fue19389/Placa-Nervio-Vago-Fase-5/Presentacion/pcb6.jpg

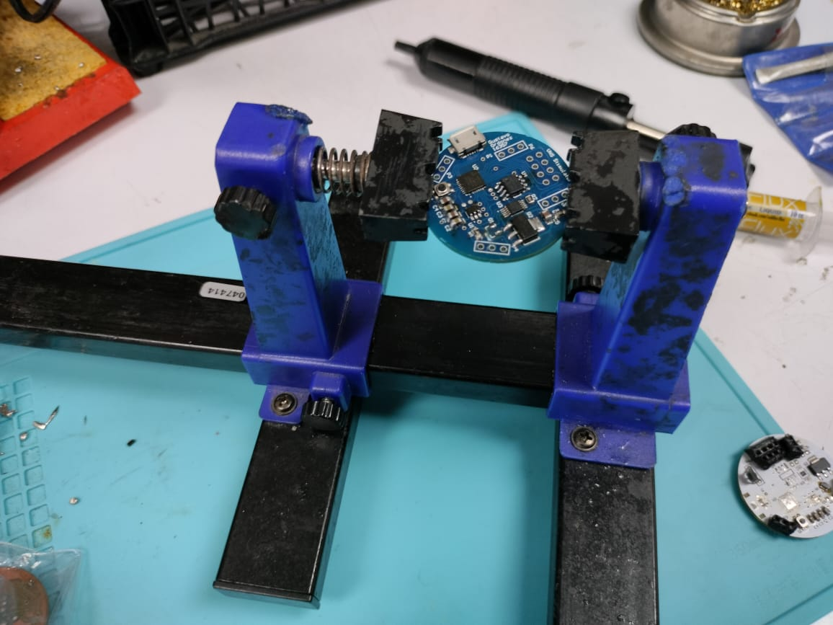
Presentacion/pcb6.jpg
