fue19389/Placa-Nervio-Vago-Fase-5/Presentacion/pcb4.jpg

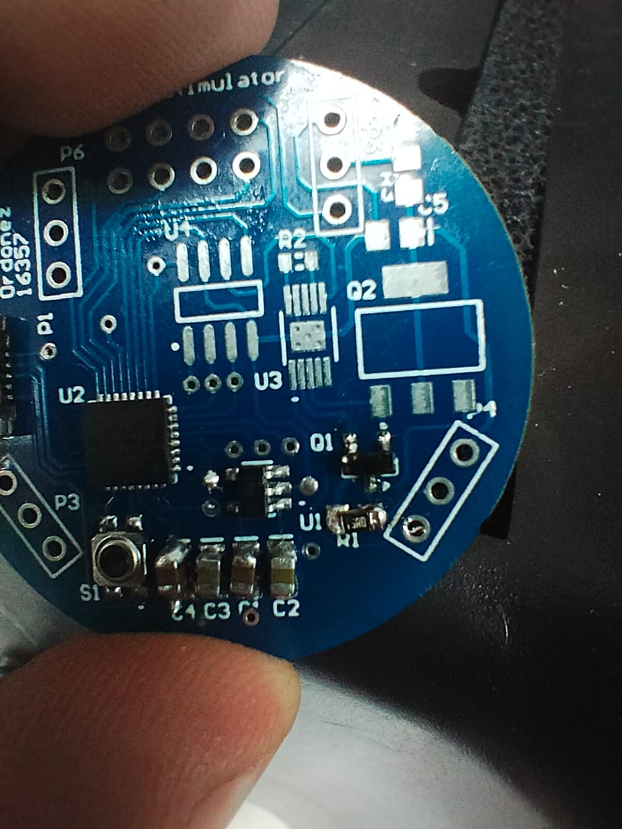
Presentacion/pcb4.jpg
