fue19389/Placa-Nervio-Vago-Fase-5/README.md

# Placa-Nervio-Vago-Fase-5

Este repositorio tiene como objetivo mostrar la documentación utilizada para la realización parcial del proyecto Estimulador del Nervio Vago, el cual no pudo ser terminado. 
Sin embargo, contiene las observaciones para que la próxima persona encargada sea capaz de continuar con la investigación y desarrollo de prototipos.
