fue19389/Placa-Nervio-Vago-Fase-5/Simulaciones/README.md

# Simulaciones

En este apartado encontrarán: 

- SAMD-D21.pdf: Este archivo es la hoja de datos del microcontrolador utilizado para la generación de pulsos del Estimulador del Nervio Vago.

- XTR111.zip: Este archivo contiene los modelos Spice del integrado que funciona para convertir voltaje a corriente.

- Spicemodels_p_channel: Este archivo contiene los modelos spice para un MOSFET Canal P de 100v-

- Simulaciones: En esta carpeta se encuentran los archivos utilizados para la simulación en LTSpice VII del convertidor de voltaje a corriente.
