fue19389/Placa-Nervio-Vago-Fase-5/Reporte/README.md

# Reporte final del estimulador del nervio vago

En este reporte se podrá encontrar una descripción de las observacinoes realizadas para el proyecto del Estimulador del Nervio Vago. En este caso se presentan resúmenes de: 
- Revisión de software
- Revisión de componentes y adjunto de hojas de datos
- Resumen de simulaaciones de funcionamiento
- Revisión parcial de funcionamiento (de la sección del convertidor de voltaje a corriente)
- Conclusiones
- Recomendaciones
