fue19389/Placa-Nervio-Vago-Fase-5/Tesis/README.md

# Documento de tesis

Este documento en formato PDF muestra la tesis incompleta que fue inciada por Gerardo Fuentes.
