fue19389/Placa-Nervio-Vago-Fase-5/Presentacion/README.md

# Documentos utilizados para la presentación de resultados

En este apartado encontrarán: 
- Archivos con extensión .jpg los cuales fueron usados para hacer demostraciones de los avances de resultados.
- Un archivo nombrado "22" el cual contiene la última presentación de avances ralizada.
