fue19389/Placa-Nervio-Vago-Fase-5/Simulaciones/LTSpice/README.md

XTR111 LTspice Model
====================

XTR111 LTspice basado en el modelo encontrado en https://e2e.ti.com/support/amplifiers/precision_amplifiers/f/14/t/170869 for TINA-TI.

Archivos
-----

- XTR111.asc: Esquemático con el modelo XTR111 LTspice.
- XTR111.asy: Symbolo para el uso de XTR111 en otros esquemáticos.
- XTR111 Simulation.asc: Ejemplo de utilización del modelo.

Uso del modelo
----------------

Para el uso del XTRR111 se deben copiar los archivos XTR111.asc y XTR111.asy en el directorio de trabajo.

Instrucciones:
- Click on "Component".
- En la pestaña o botón "Top Directory", seleccionar el directorio actual.
- En este espacio debería aparecer el integrado XTR111, seleccionar y colocar en el esquemático.

Notas
-----

- Este modelo únicamene funciona con LTSpice
- Este modelo no es el oficial, y fue creado para para ayudar a los clientes y otras personas intersadas en entender el funcionamiento del XTR111. No será preciso al simular varios de los parámetros de la hoja de datos, pero es útil para entender el funcionamiento.

Licencia
-------

El modelo XTR111 LTspice es distribuido bajo los términos del la licencia del MIT.
