fue19389/Placa-Nervio-Vago-Fase-5/Presentacion/falstad.jpg

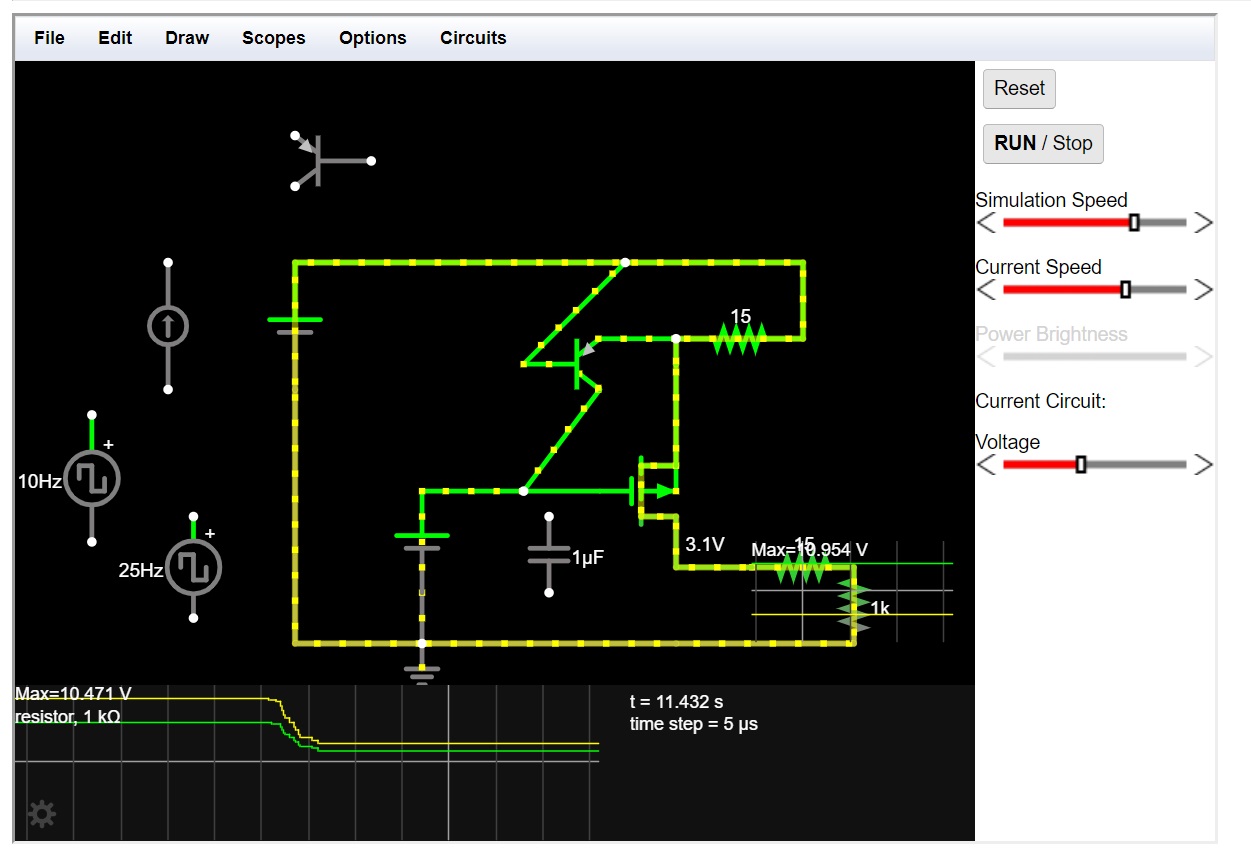
Presentacion/falstad.jpg
