fue19389/Placa-Nervio-Vago-Fase-5/Presentacion/pcb2.jpg

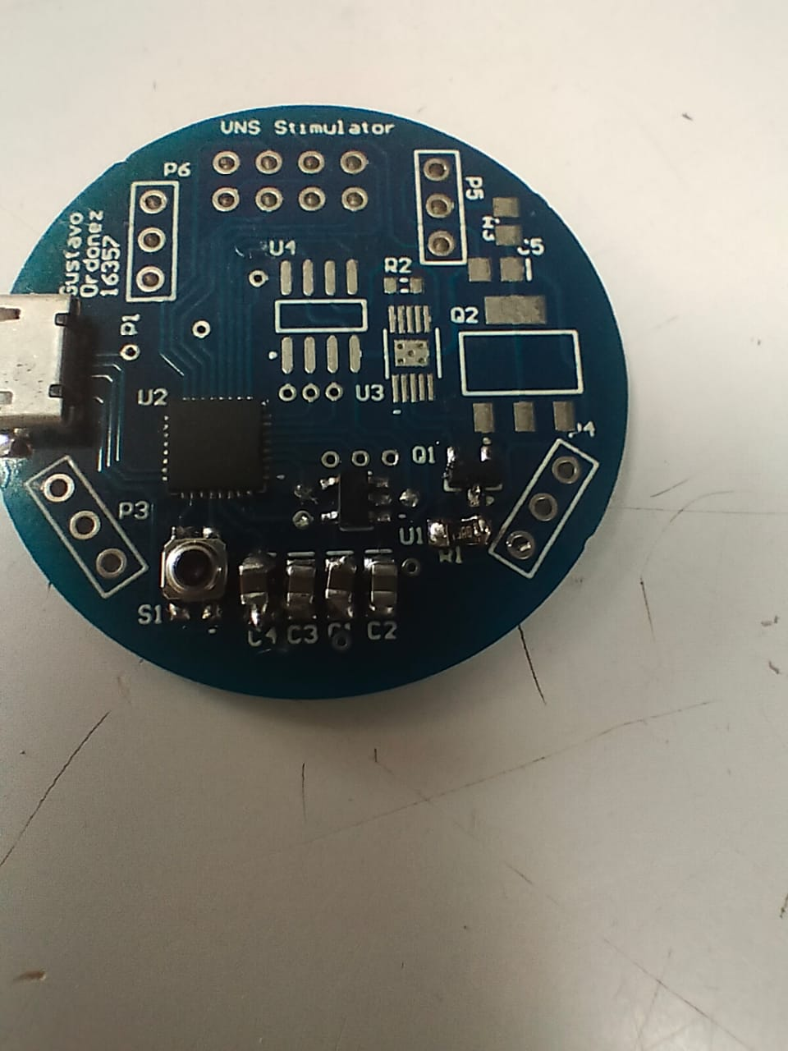
Presentacion/pcb2.jpg
