fue19389/Placa-Nervio-Vago-Fase-5/Presentacion/pcb3.jpg

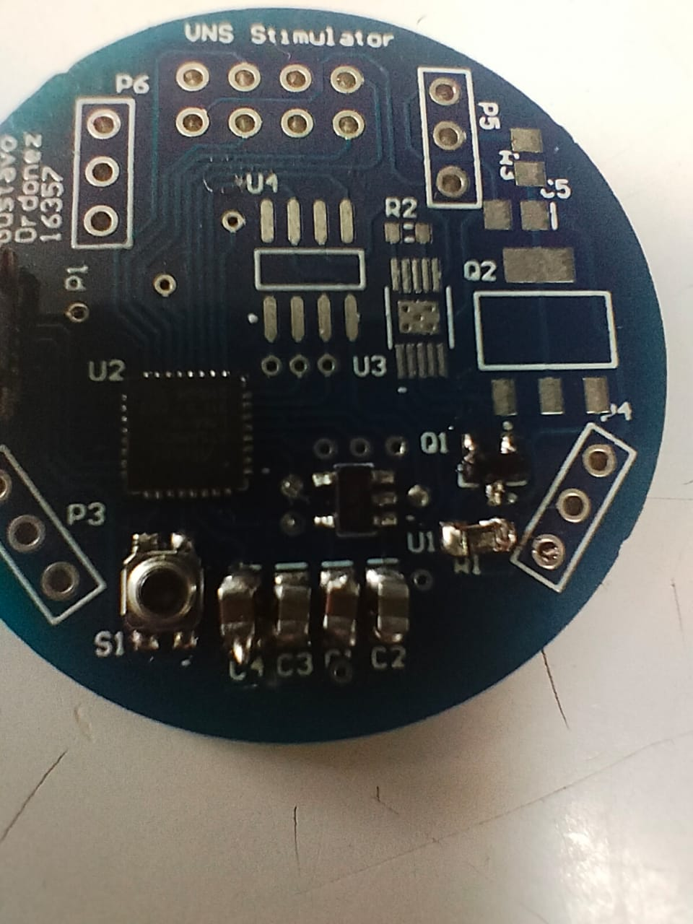
Presentacion/pcb3.jpg
