fue19389/Placa-Nervio-Vago-Fase-5/Presentacion/pcb5.jpg

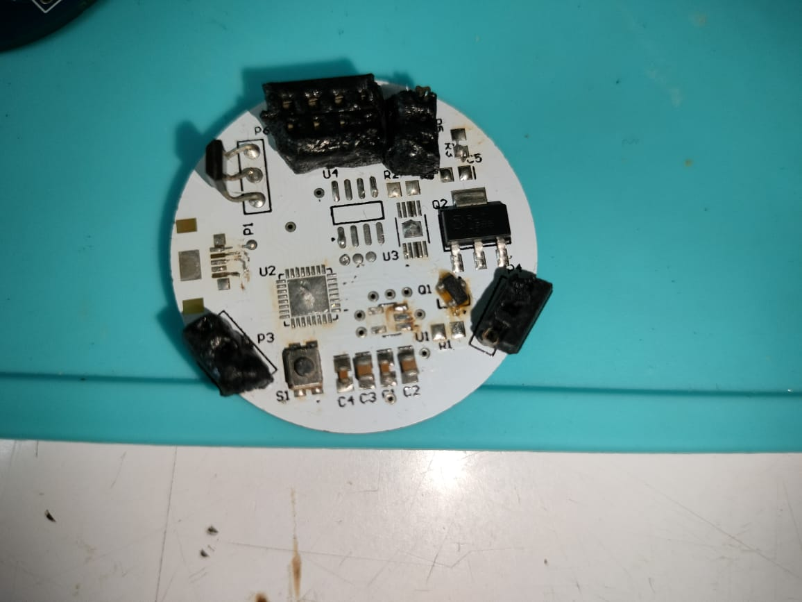
Presentacion/pcb5.jpg
