fue19389/Placa-Nervio-Vago-Fase-5/Presentacion/proto1.jpg

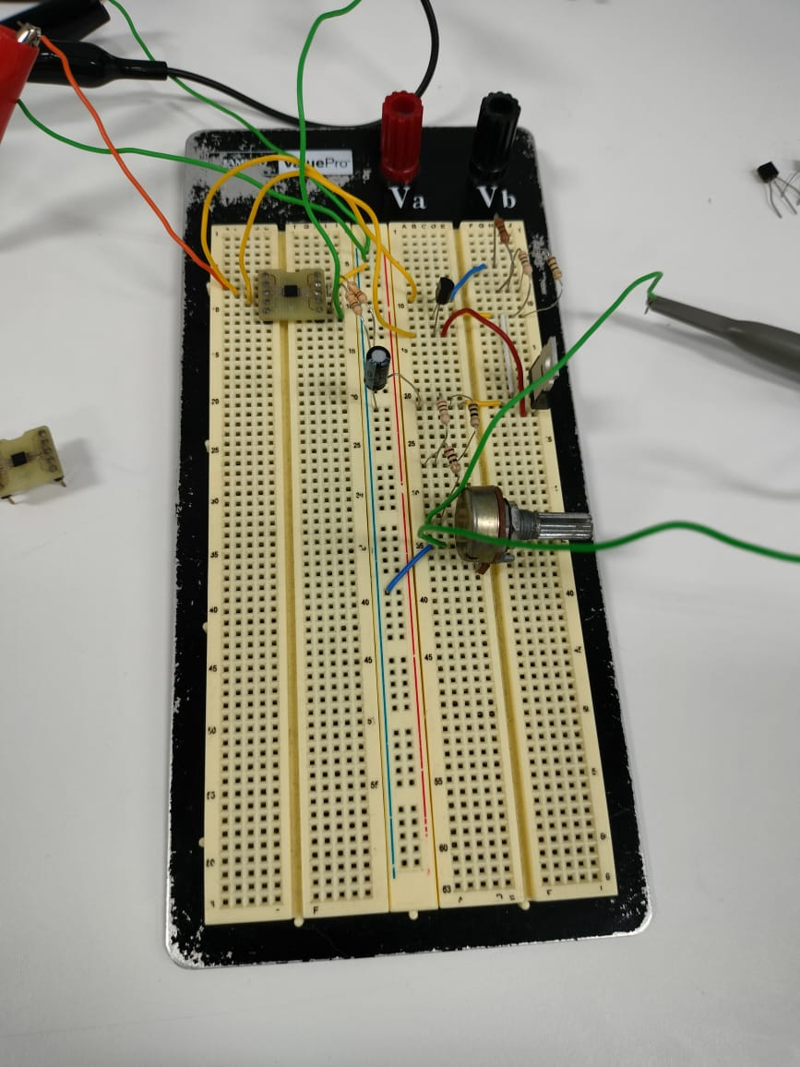
Presentacion/proto1.jpg
