fue19389/Placa-Nervio-Vago-Fase-5/Presentacion/proto2.jpg

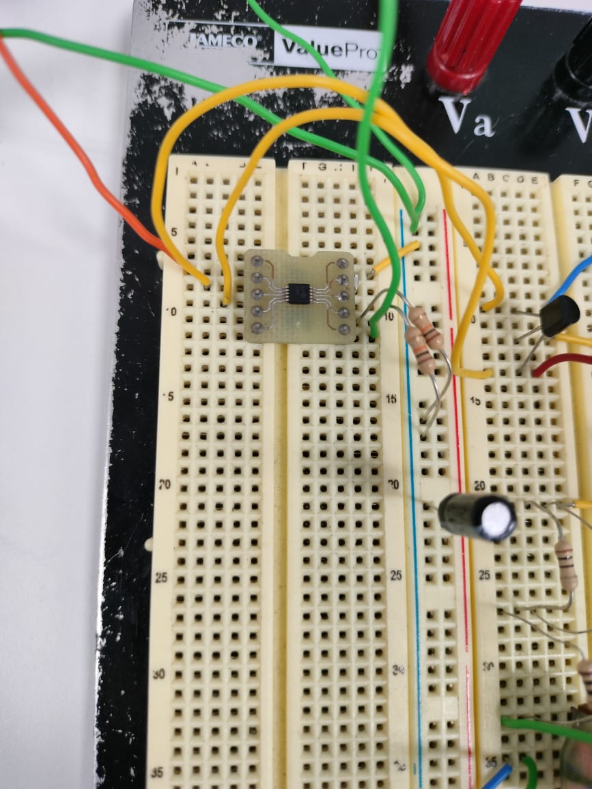
Presentacion/proto2.jpg
