fue19389/Placa-Nervio-Vago-Fase-5/Presentacion/vi.jpg

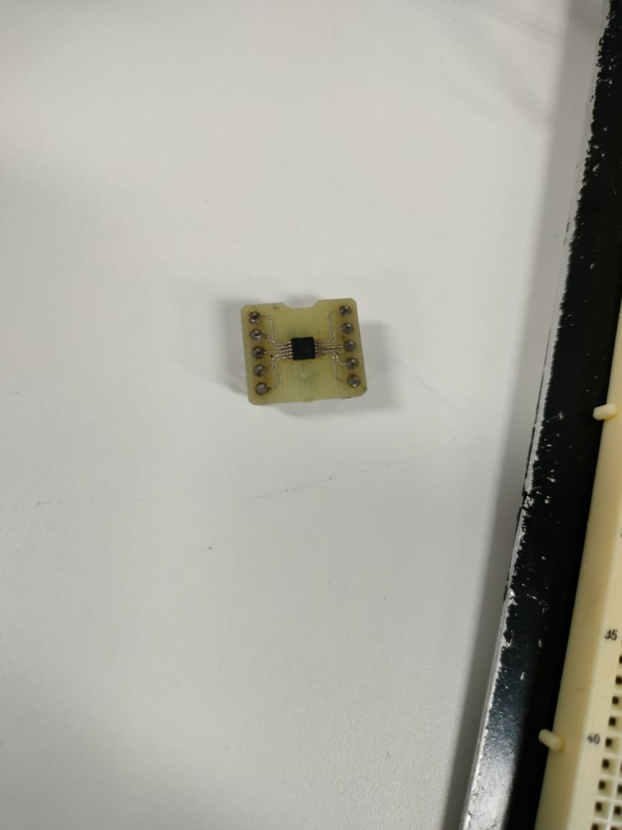
Presentacion/vi.jpg
