fue19389/Placa-Nervio-Vago-Fase-5/Presentacion/VI_5K_SET.jpg

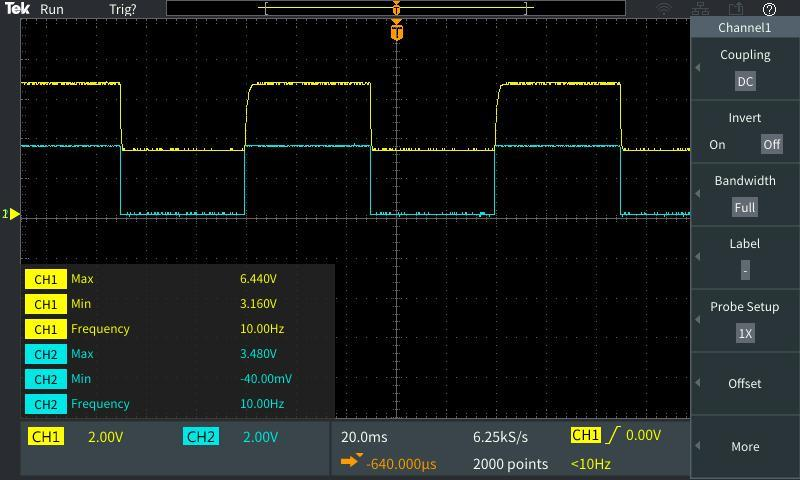
Presentacion/VI_5K_SET.jpg
