fue19389/Placa-Nervio-Vago-Fase-5/Presentacion/WhatsApp Image 2023-09-01 at 03.13.22.jpg

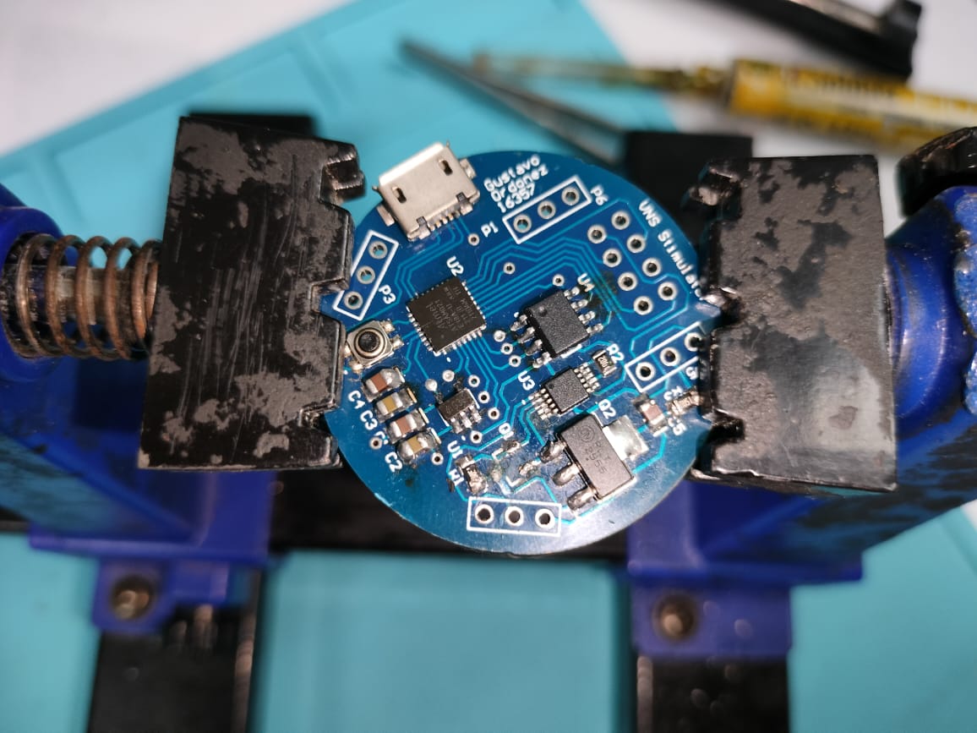
Presentacion/WhatsApp Image 2023-09-01 at 03.13.22.jpg
