fue19389/Placa-Nervio-Vago-Fase-5/Presentacion/22.pdf

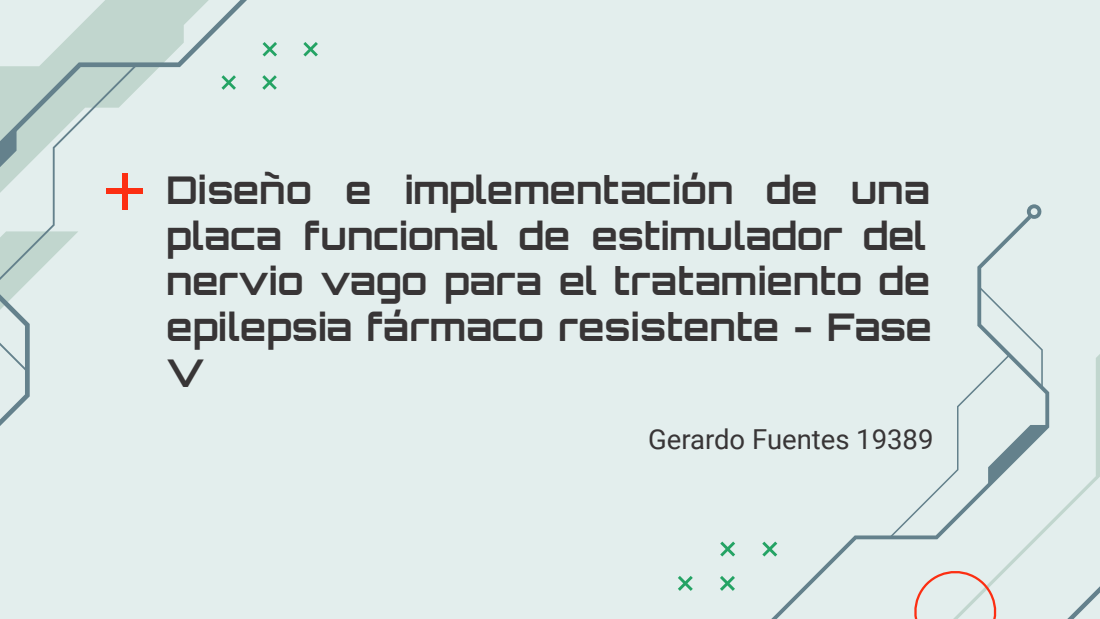
[picture p27: page 1]
Gerardo Fuentes 19389

Diseño e implementación de una
placa funcional de estimulador del
nervio vago para el tratamiento de
epilepsia fármaco resistente - Fase

## ÍNDICE

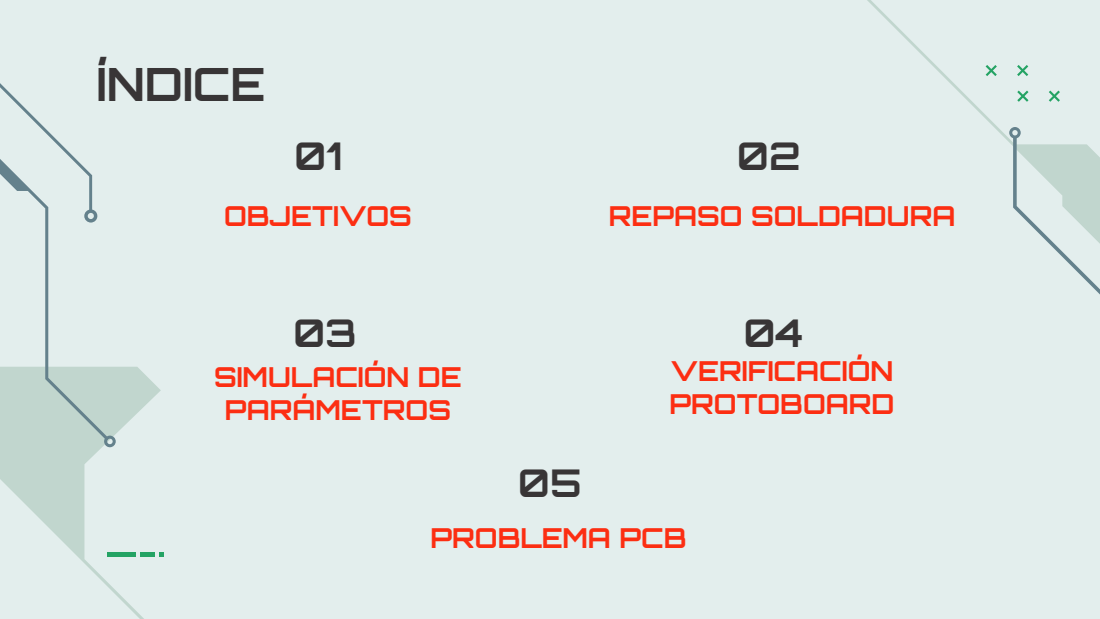
[picture p28: page 2]
OBJETIVOS; 03 SIMULACIÓN DE PARÁMETROS; 04 VERIFICACIÓN PROTOBOARD; REPASO SOLDADURA; PROBLEMA PCB

01

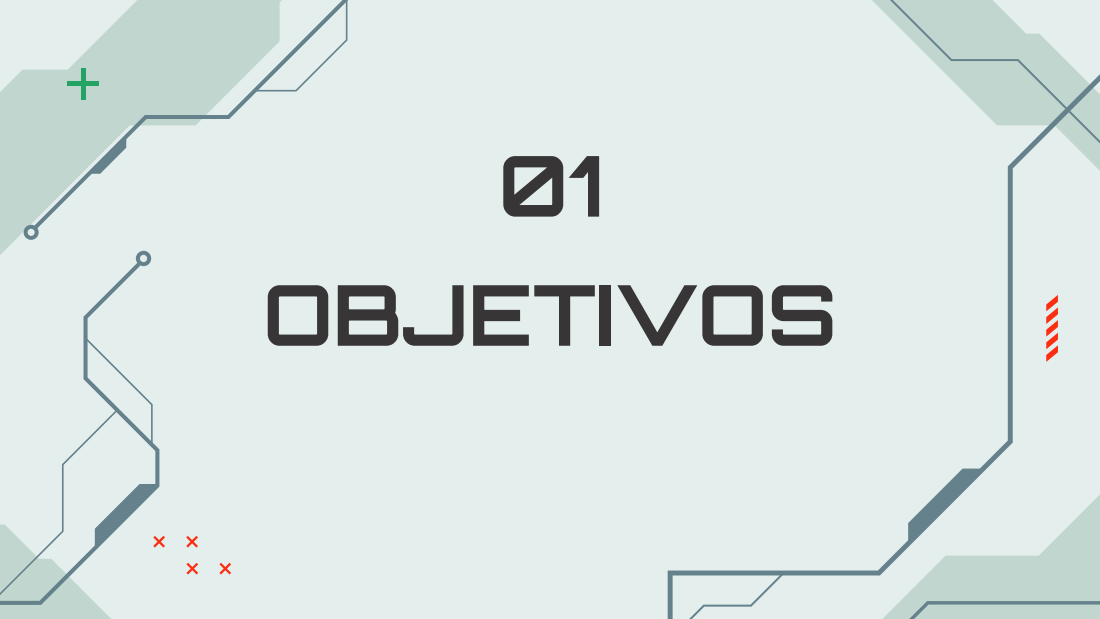
[picture p29: page 3]
OBJETIVOS

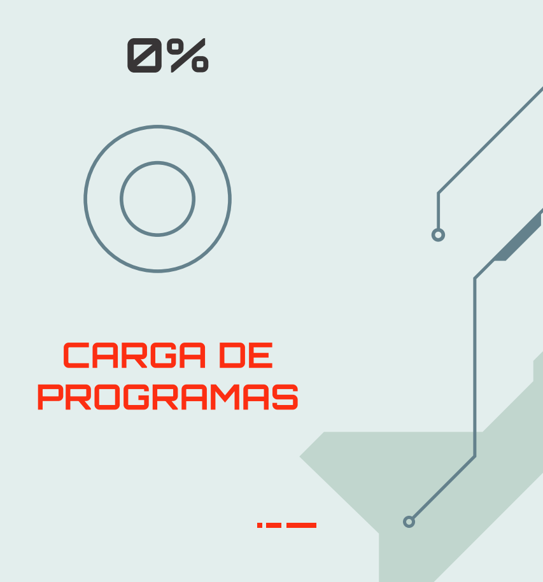
[picture p30: figure]
CARGA DE PROGRAMAS

60% | 0%

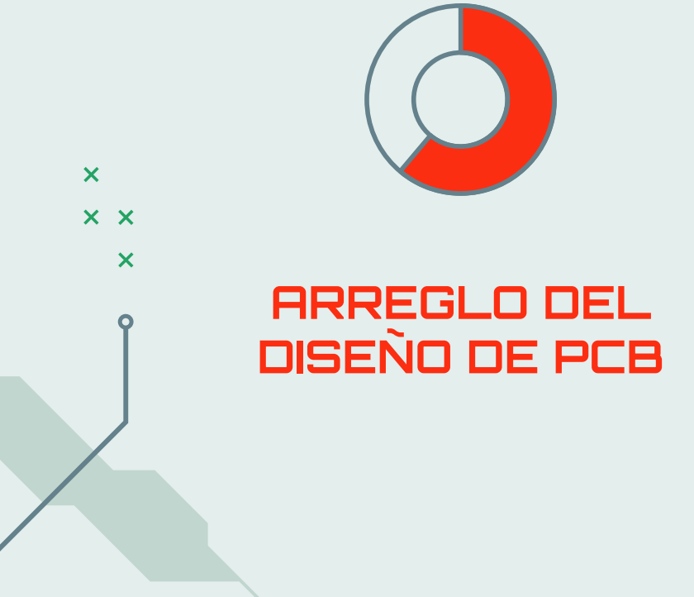
[picture p31: figure]
ARREGLO DEL DISEÑO DE PCB

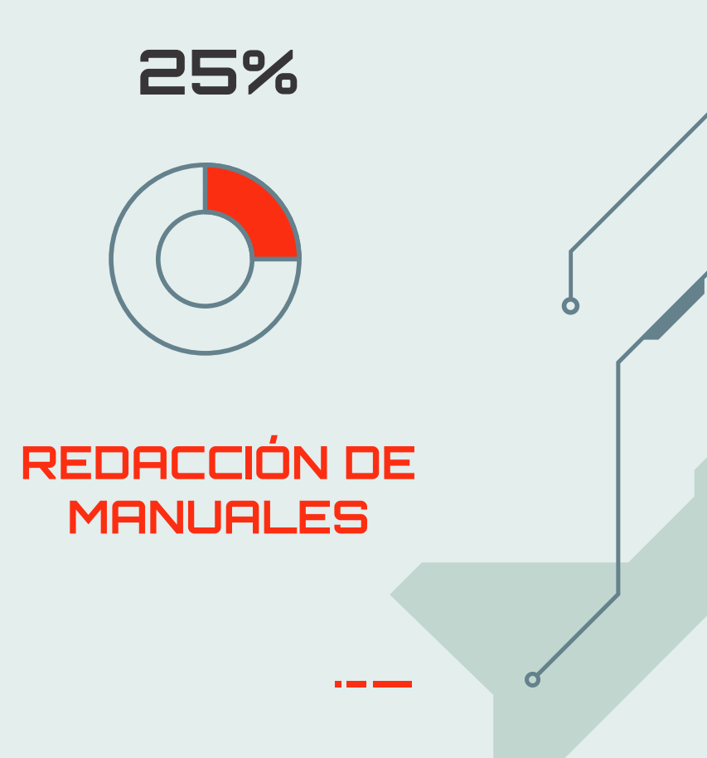
[picture p32: figure]
REDACCIÓN DE MANUALES

0% | 25%

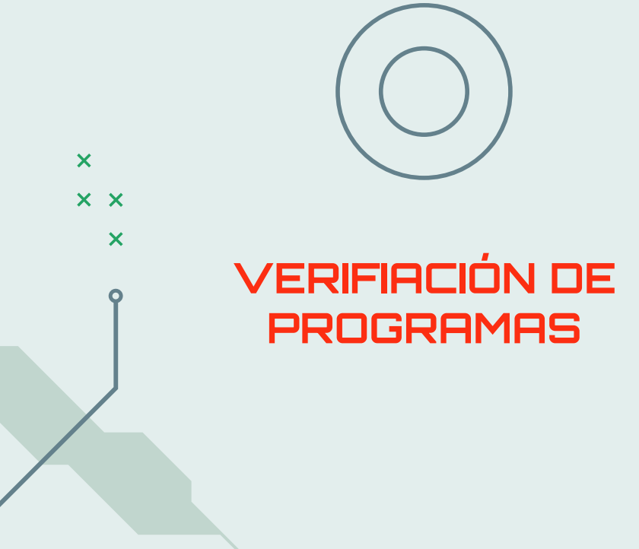
[picture p33: figure]
VERIFIACIÓN DE PROGRAMAS

02

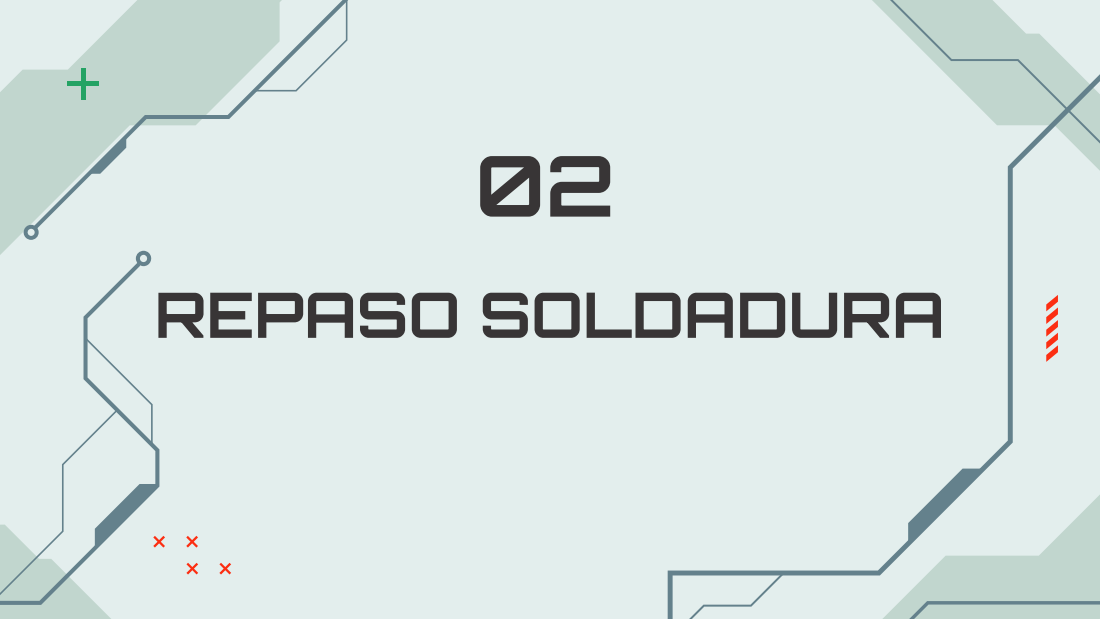
[picture p34: page 6]
REPASO SOLDADURA

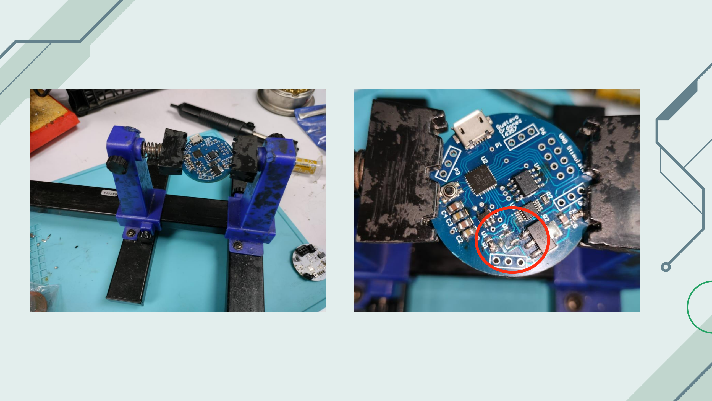
[picture p35: page 7]
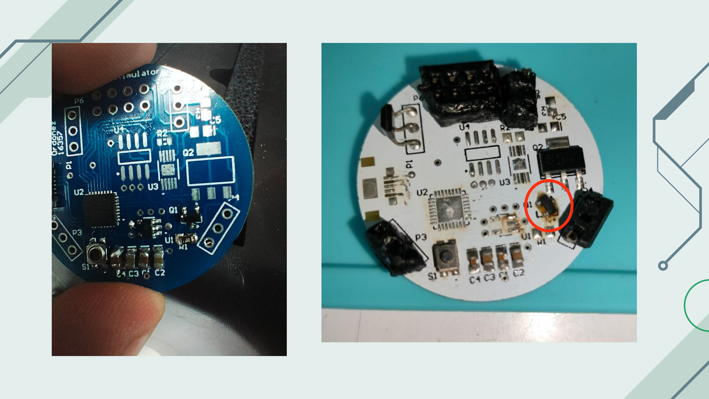
[picture p36: page 8]

03

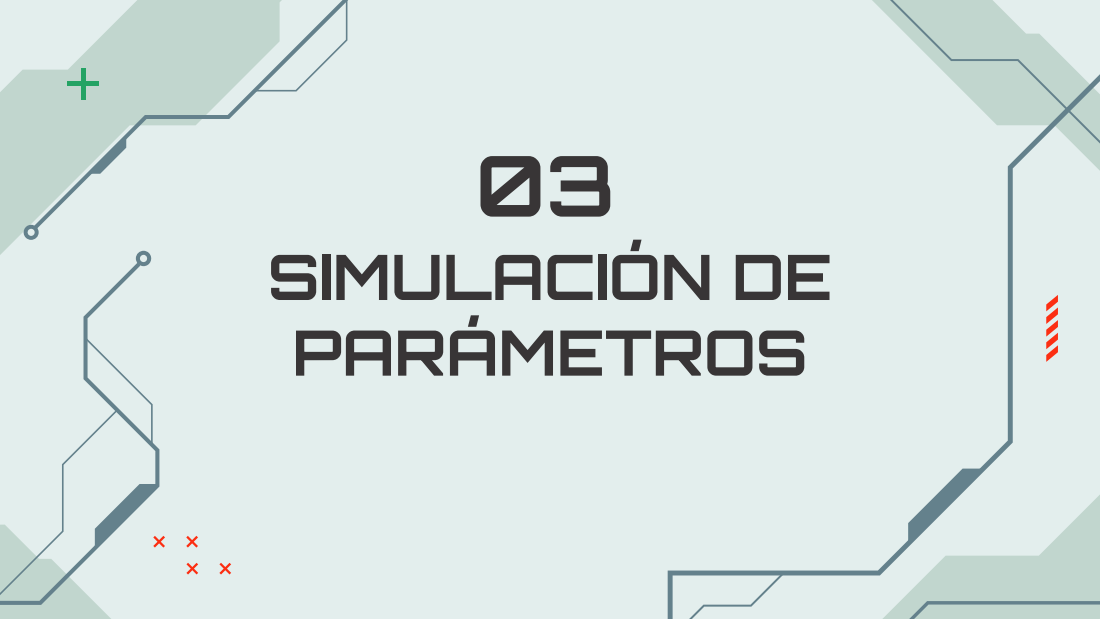
[picture p37: page 9]
SIMULACIÓN DE PARÁMETROS

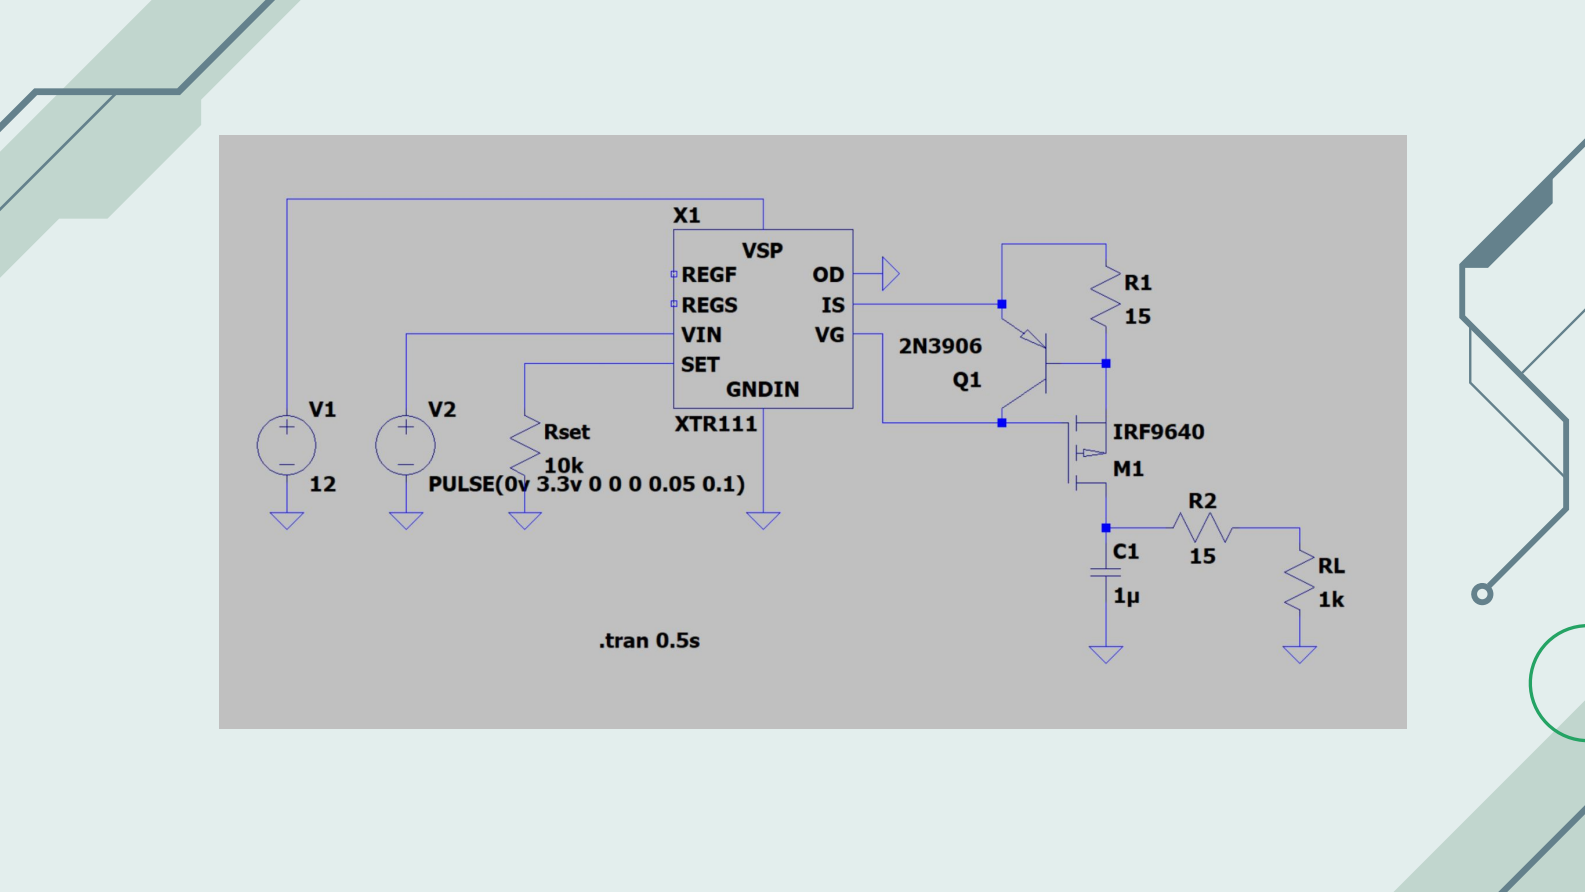
[picture p38: page 10]

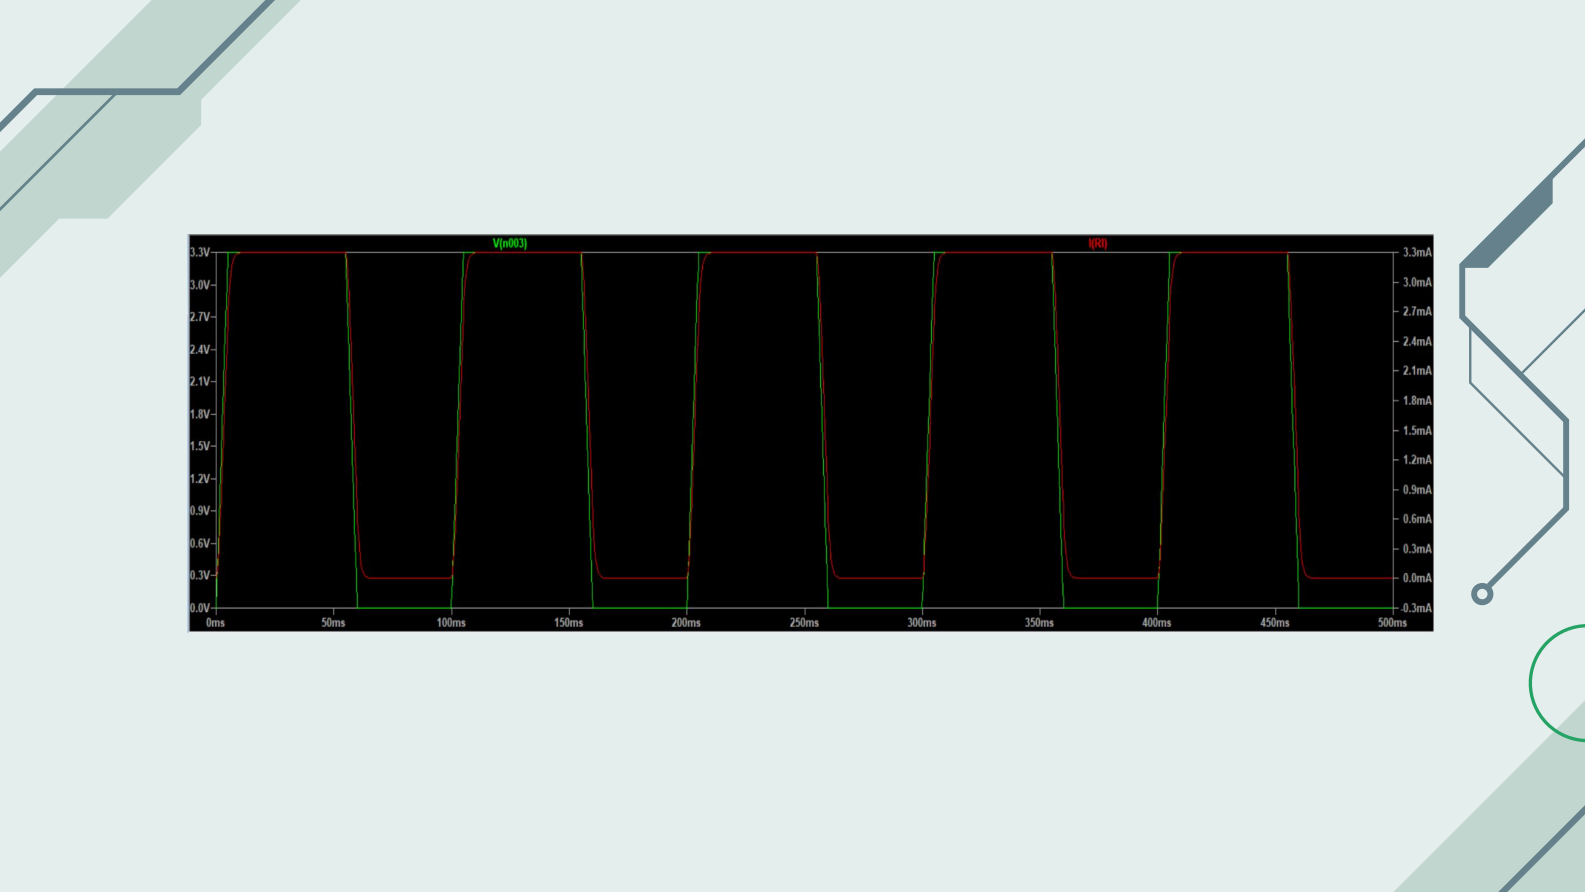
[picture p39: page 11]

04

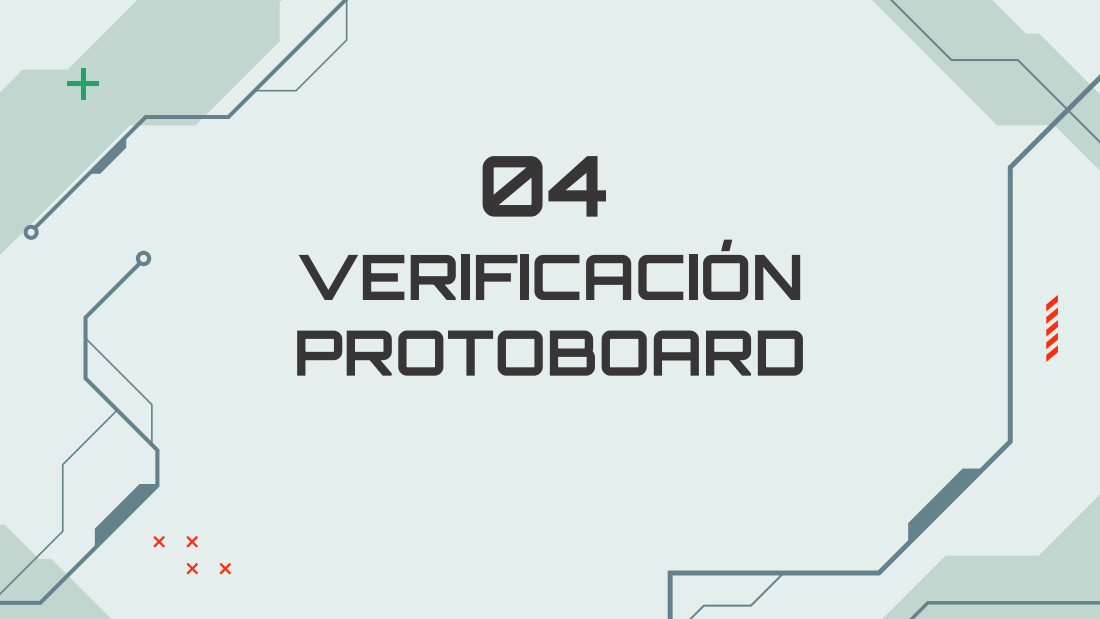
[picture p40: page 12]
VERIFICACIÓN PROTOBOARD

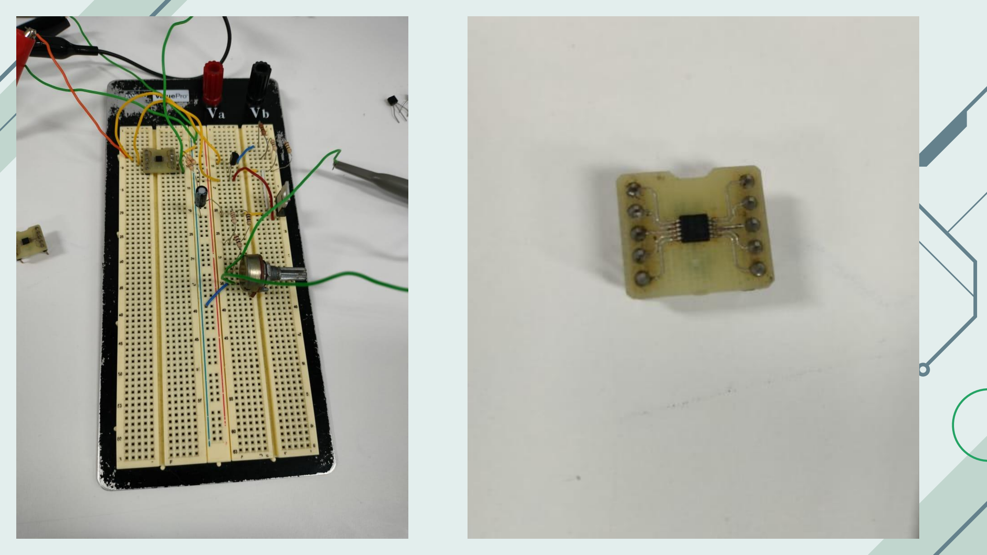
[picture p41: page 13]
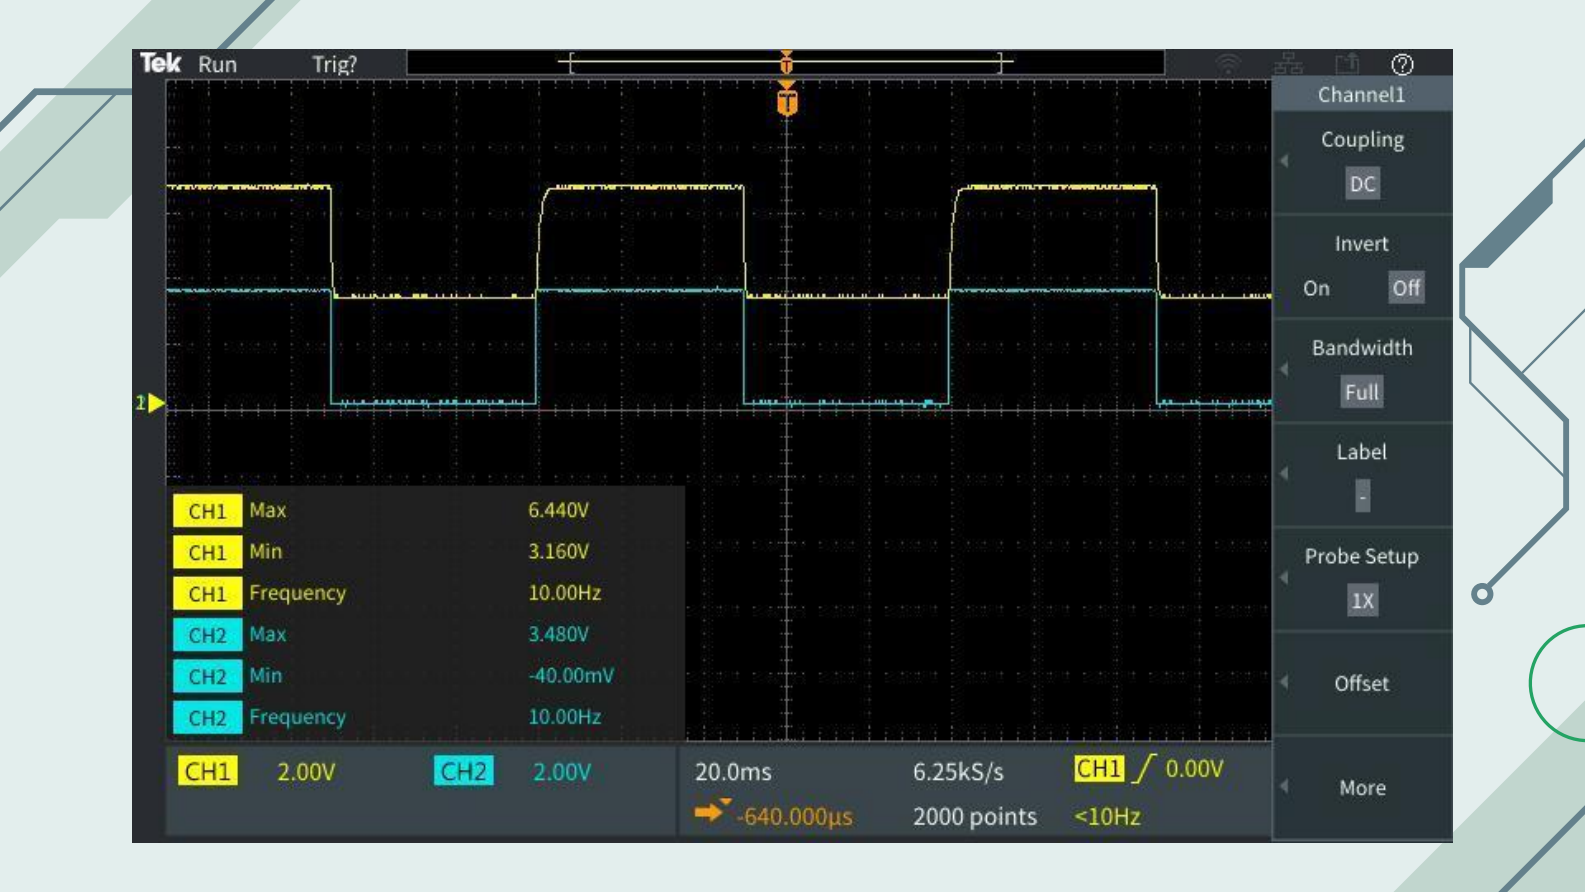
[picture p42: page 14]

05

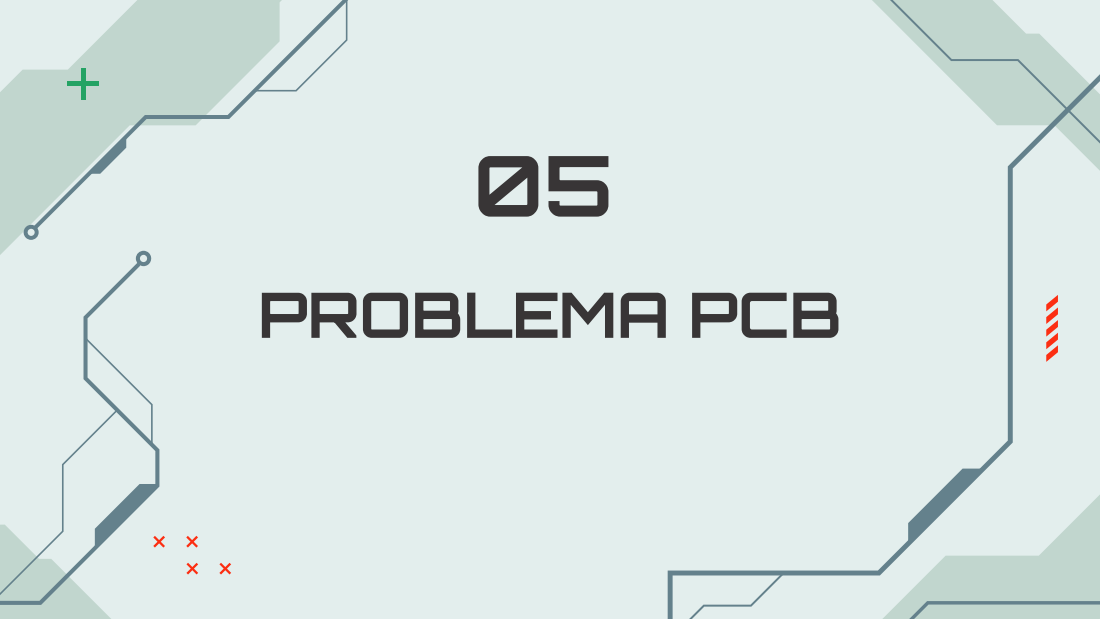
[picture p43: page 15]
PROBLEMA PCB

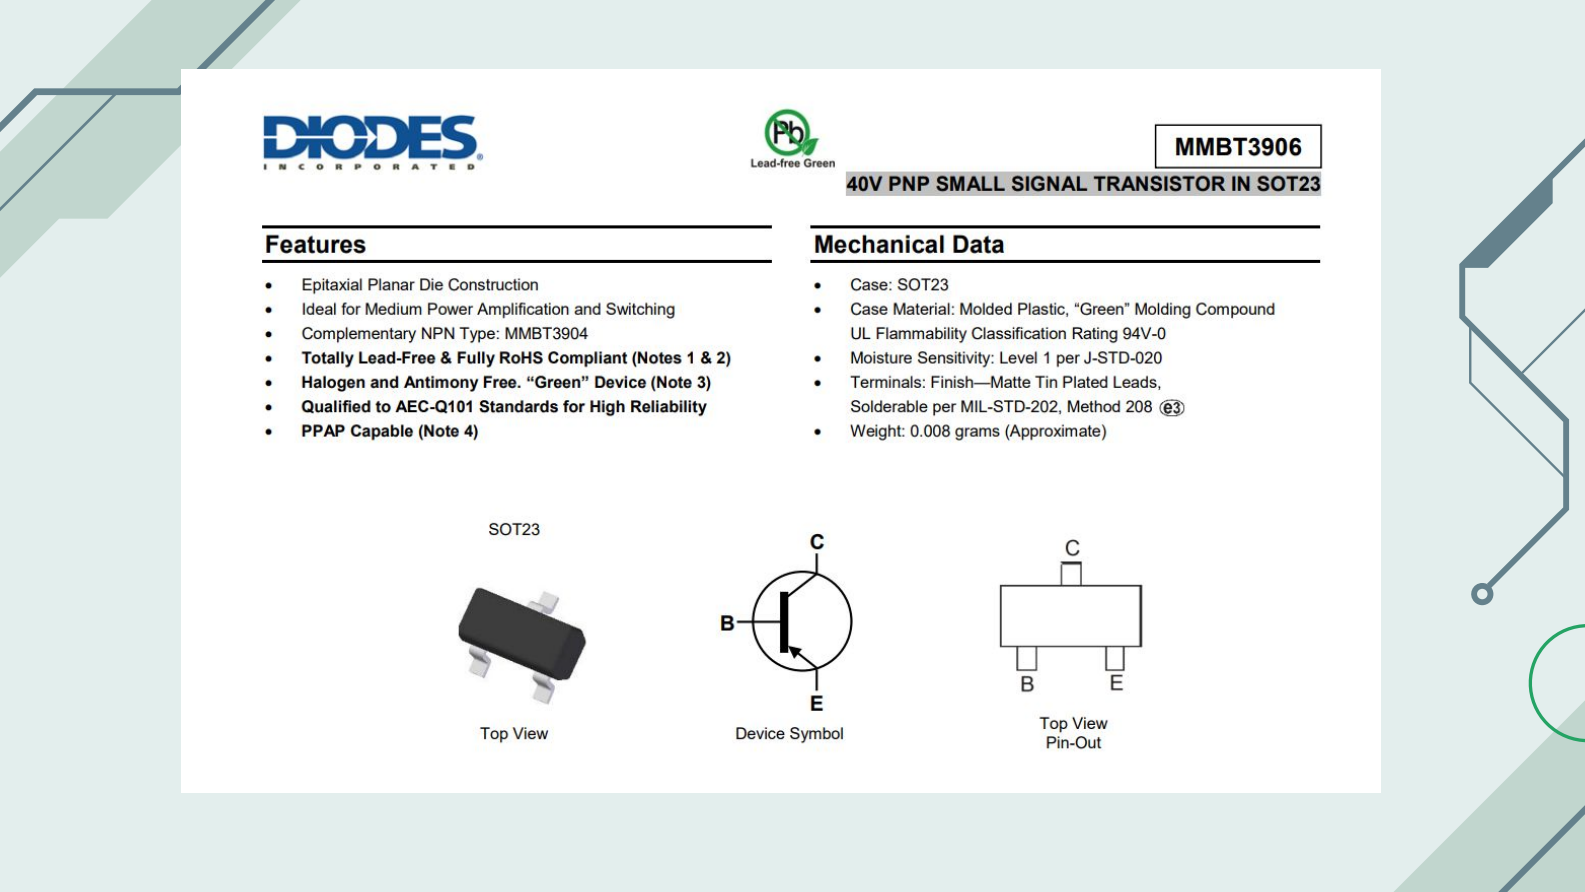
[picture p44: page 16]

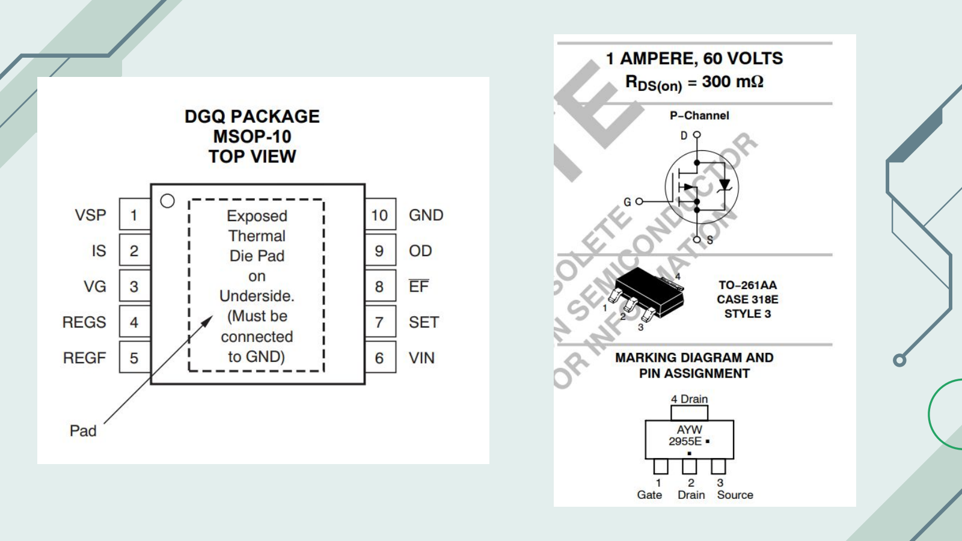
[picture p45: page 17]
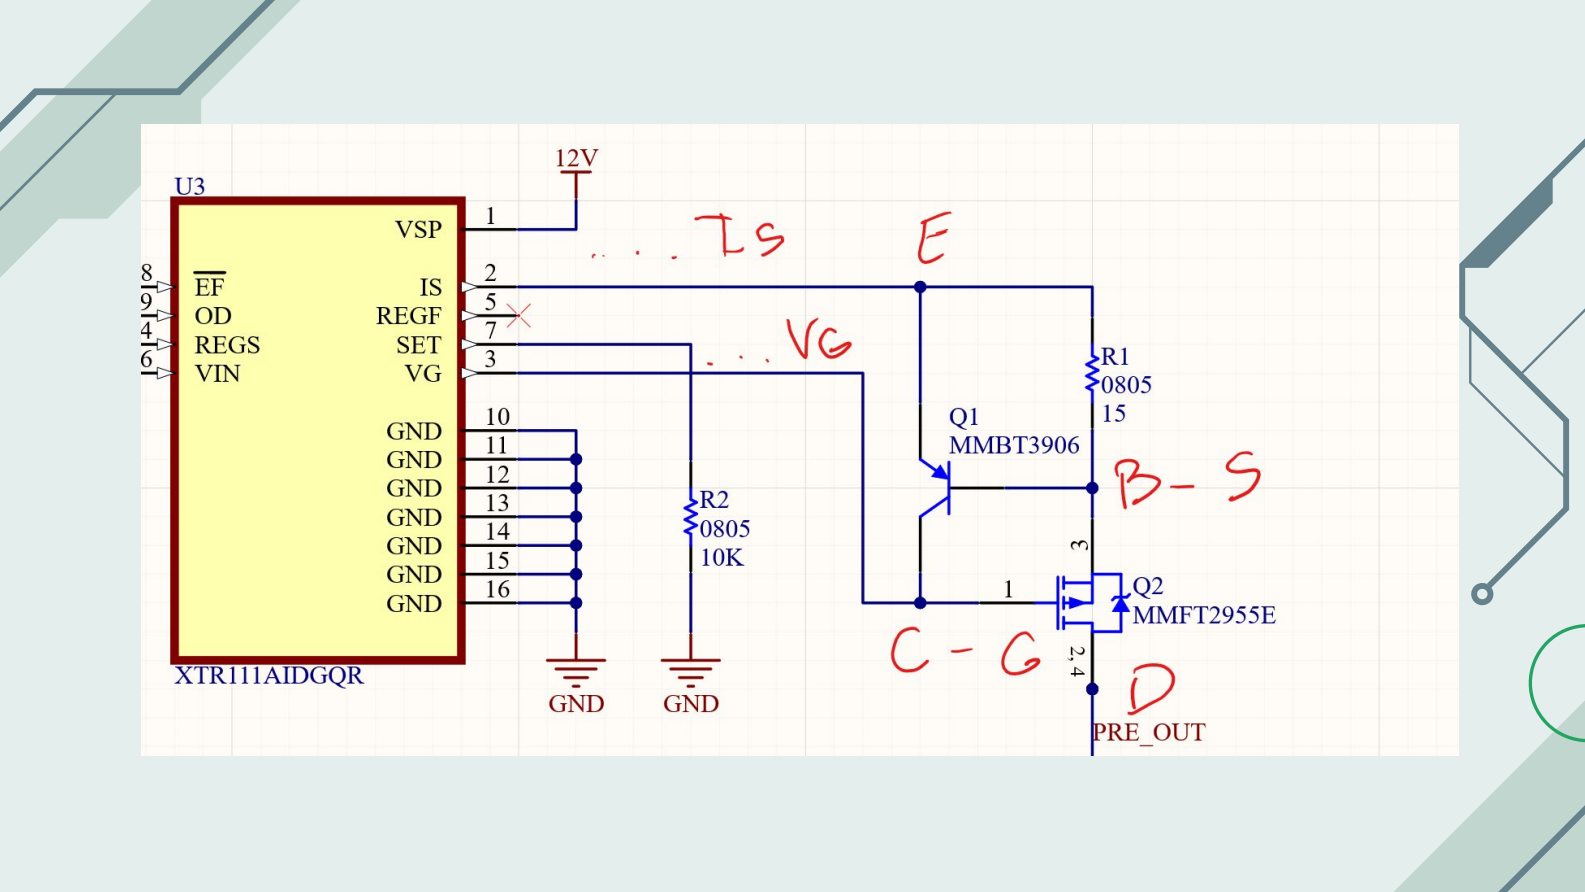
[picture p46: page 18]

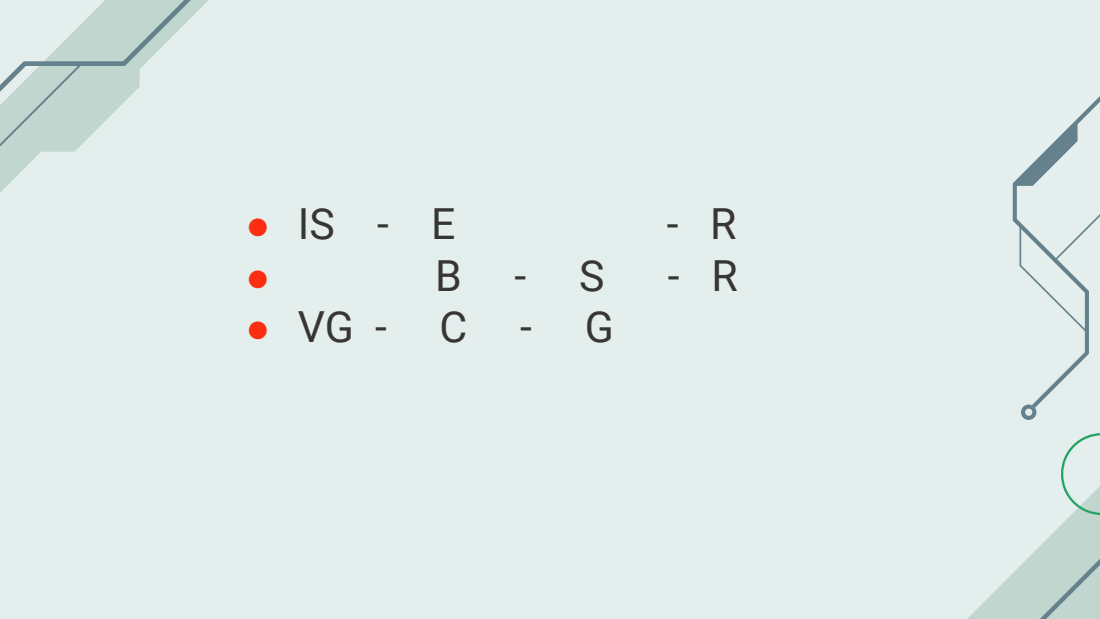
[picture p47: page 19]

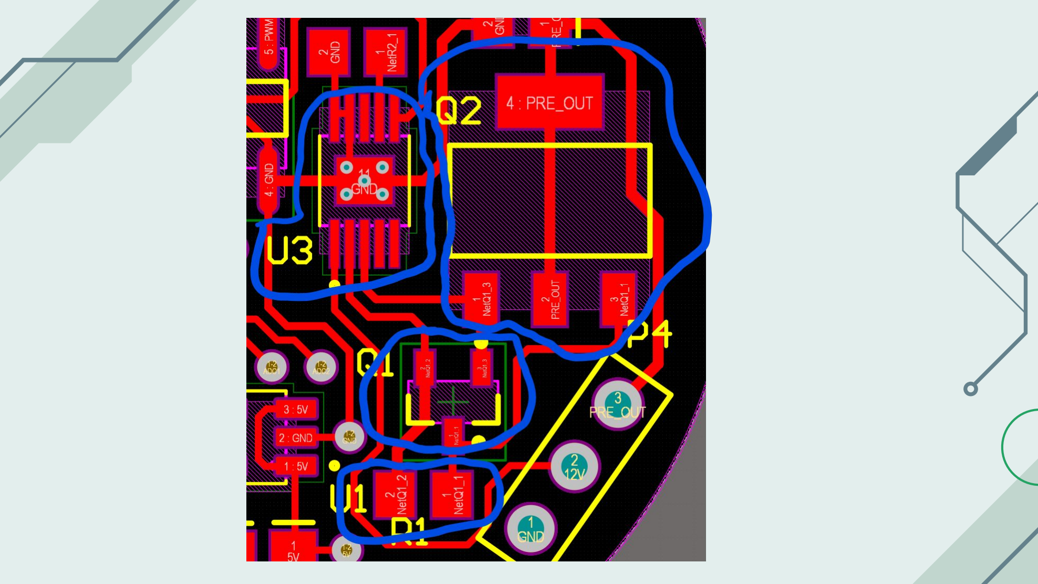
[picture p48: figure]
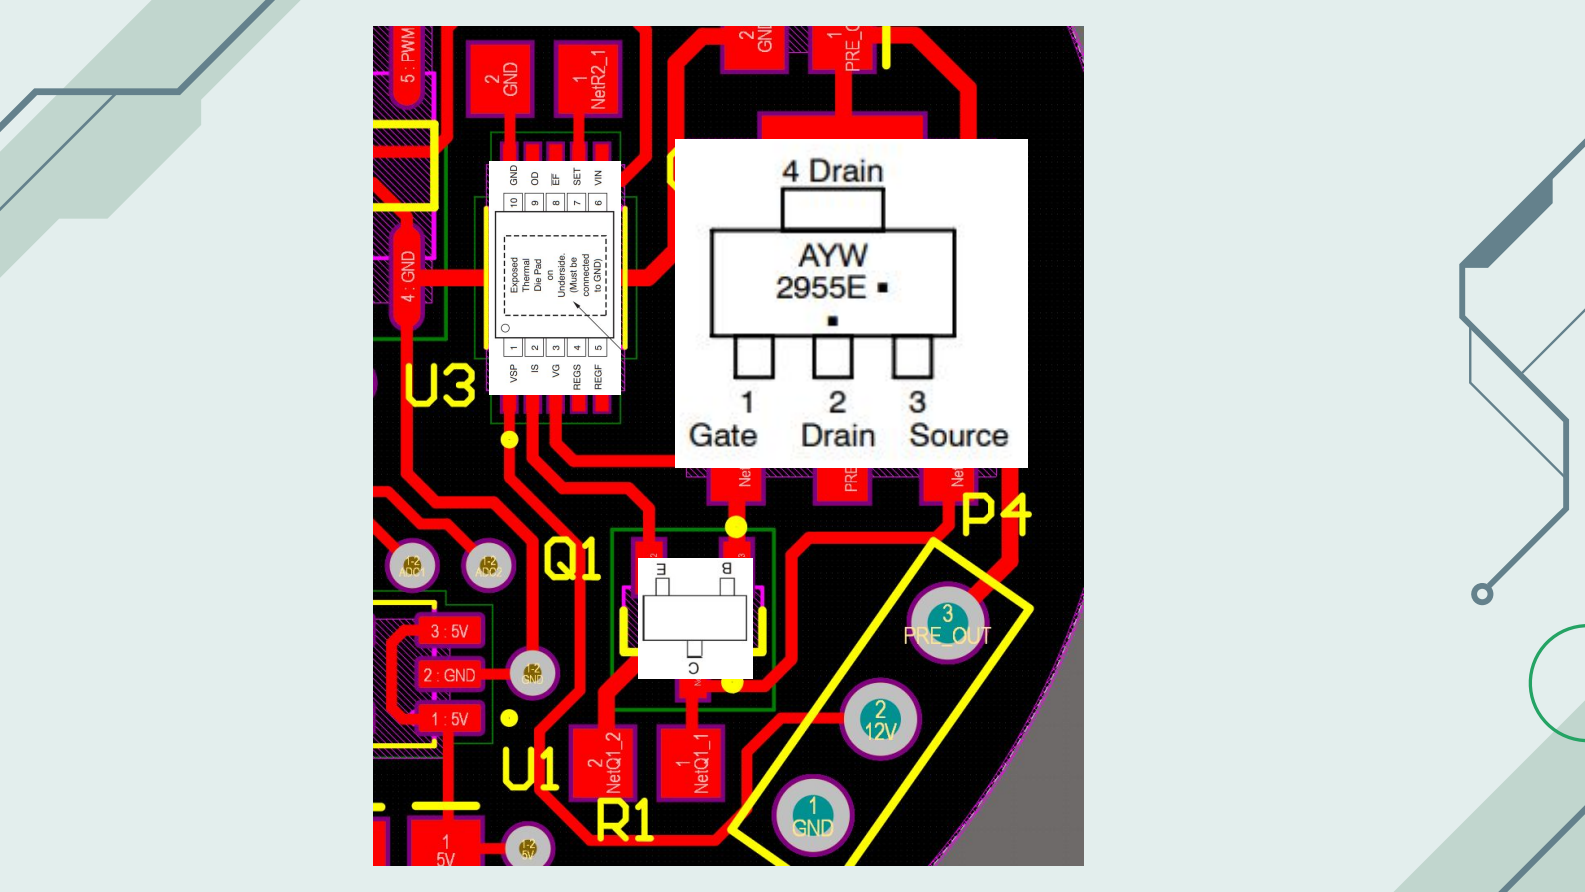
[picture p49: page 21]

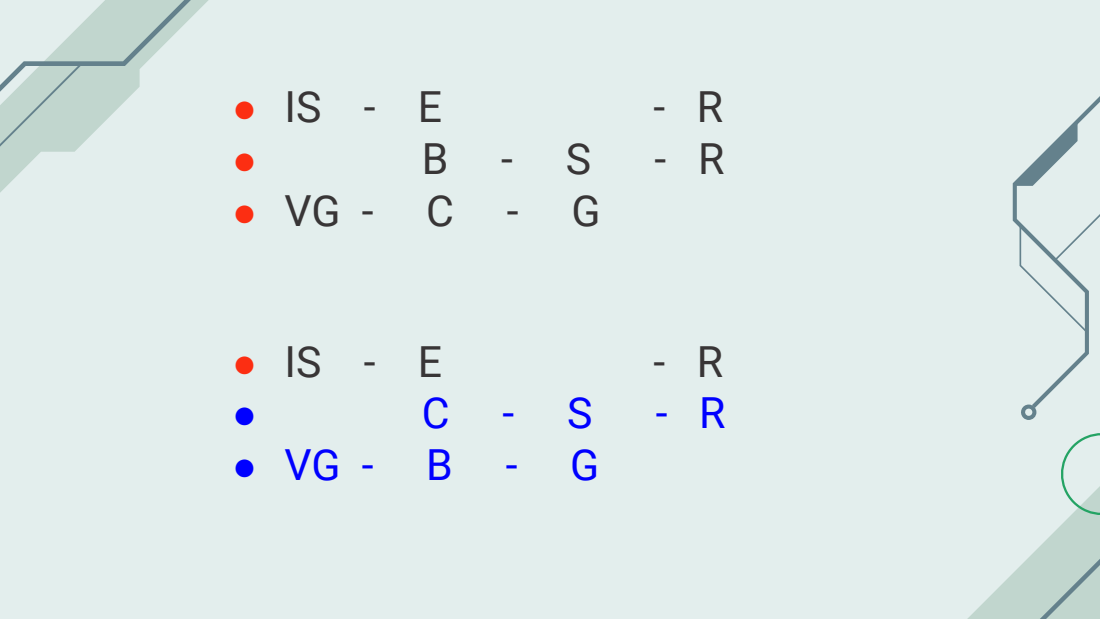
[picture p50: page 22]

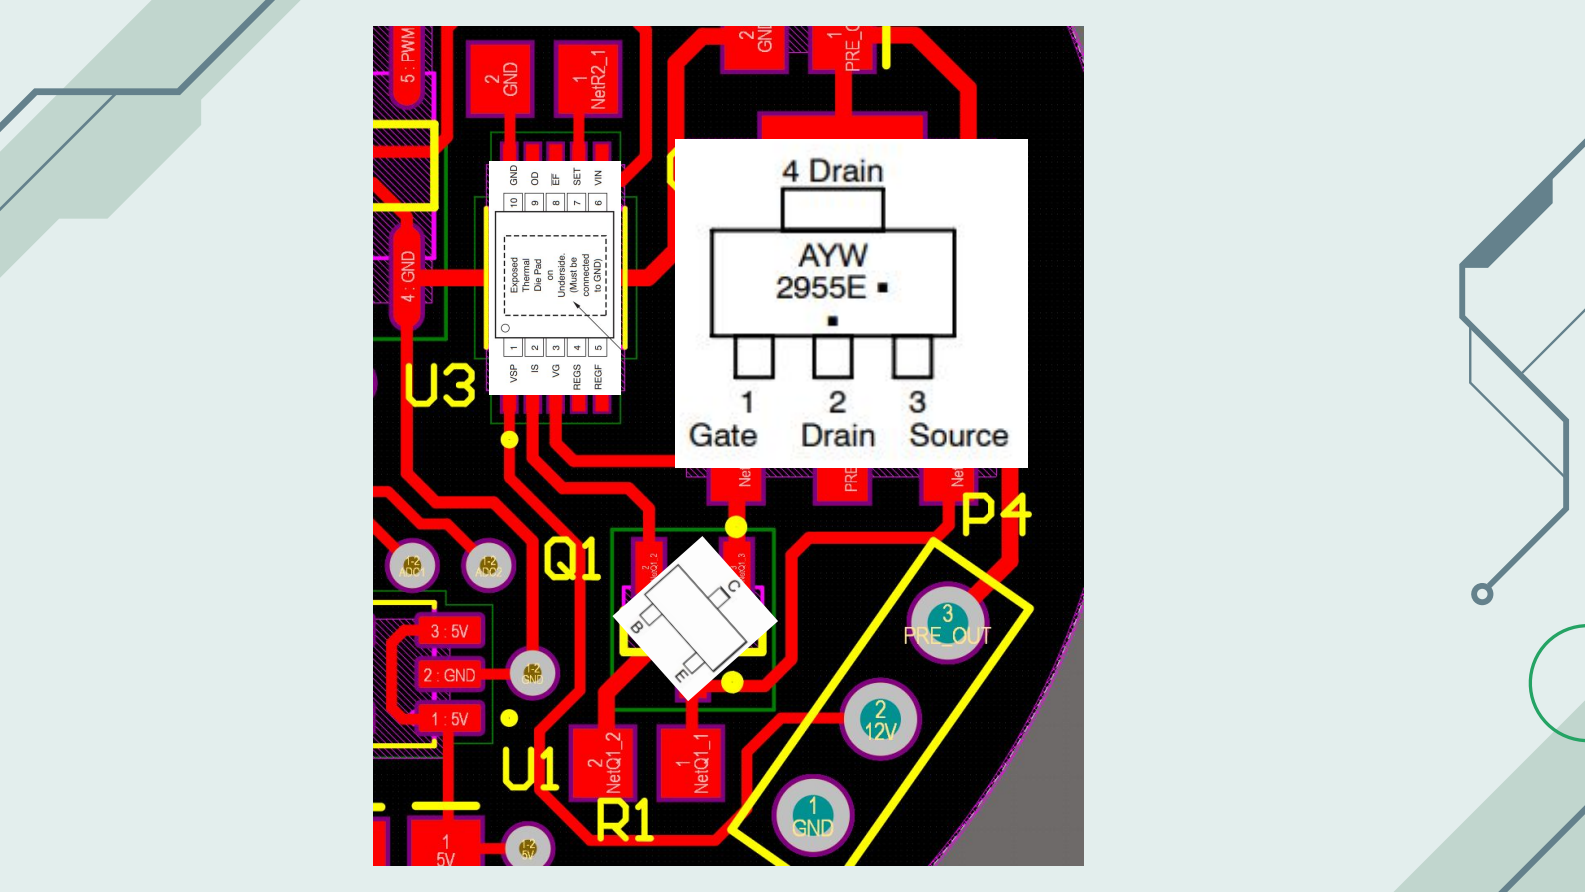
[picture p51: page 23]

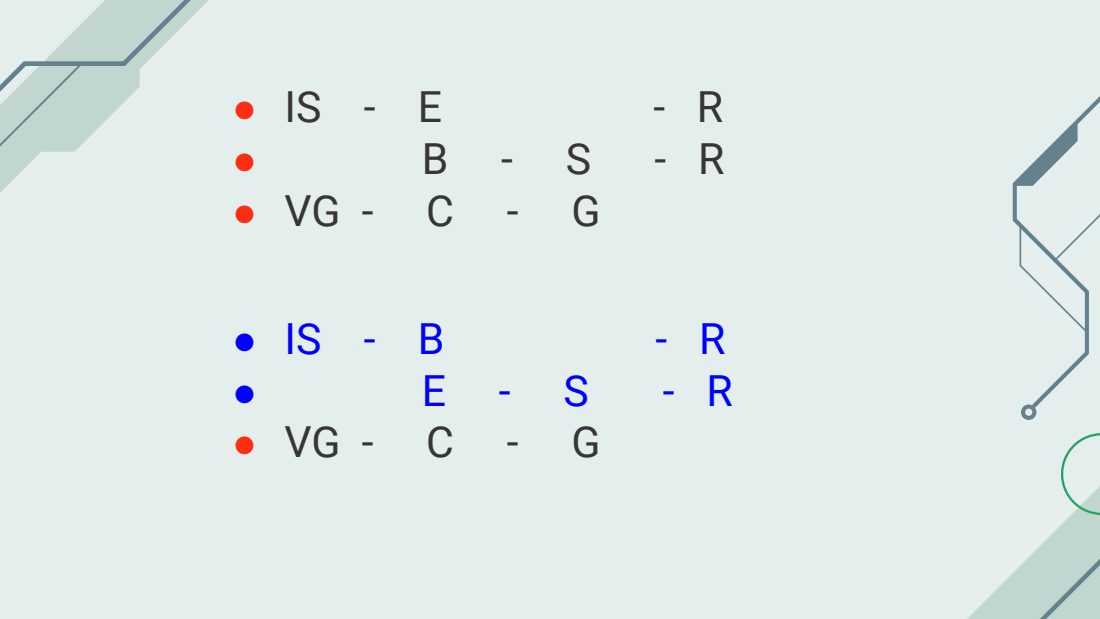
[picture p52: page 24]
