fue19389/Placa-Nervio-Vago-Fase-5/Simulaciones/LTSpice/XTR111 Simulation.asc

C1: cap; 1µ
M1: pmos; IRF9640
Q1: pnp; 2N3906
R1: res; 15
R2: res; 15
RL: res; 1k
Rset: res; 10k
V1: voltage; 12
V2: voltage; PULSE(0v 3.3v 0 0 0 0.05 0.1)
V3: voltage; 10.45
V4: voltage; PULSE(7 8 0 0 0 0.05 0.1)
X1: XTR111
Named nets: 0
.tran 0.5s
