fue19389/Placa-Nervio-Vago-Fase-5/Simulaciones/LTSpice/XTR111.asc

B1: bi; I=Id(M1)*10
Cin: cap; 30p; V=100 Irms=1
D1: diode; ES1D
D2: diode; ES1D
D3: zener; EDZV16B
D4: diode; ES1D
E1: e; 1
I1: current; 4µ
Ib: current; -15n
M1: nmos
R1: res; 10; pwr=1
Rin: res; 2.4G; pwr=1
S1: sw; XTR111SW
U1: opamp
U2: opamp
U3: opamp
V1: voltage; 3
V2: voltage; 5
V3: voltage; 1.4
Named nets: REGS, REGF, VIN, SET, VSP, GNDIN, IS, VG, OD
.model XTR111SW SW(Ron=1n Roff=1G Vt=1.2 Vh=0.6)
.lib opamp.sub
