fue19389/Placa-Nervio-Vago-Fase-5/(commit log)

2023-10-14 carpeta de simulaciones
2023-10-14 Documentación de tesis (no presentada)
2023-10-14 Sim y modelo LTSpice de XTR111
